craigyjp/MIDI-to-CV-MCP4922/midi2cvaftertouch4922.pdf

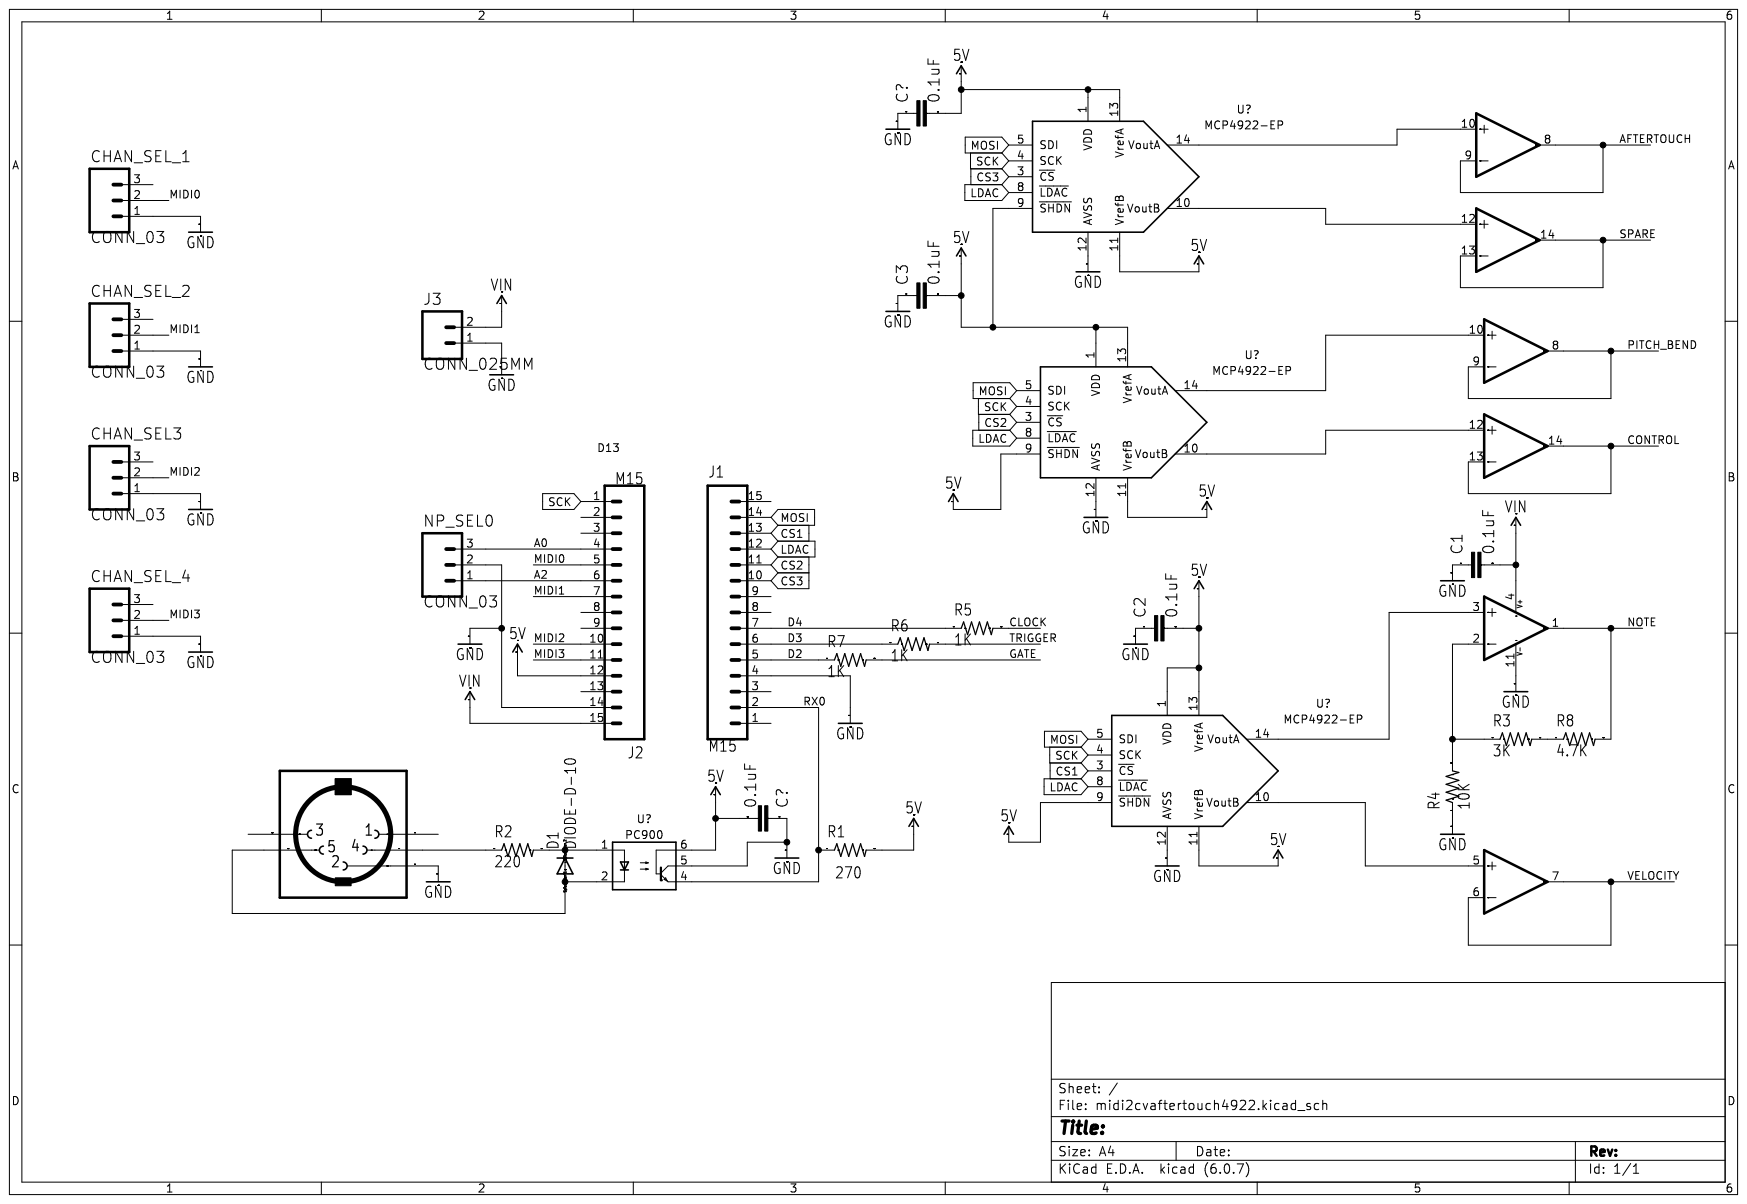
[picture p1: page 1]
