craigyjp/MIDI-to-CV-MCP4922/(commit log)

2023-01-10 Fixed clock signal - no output
    [Elkyam_MIDI_CV_Aftertouch_MCP4922.ino]
2023-01-10 Referenced calibration
